laksirisamitha/MAKEEN_Keypad_Test_PCB/MAKEEN_Keypad_Test_PCB.pdf

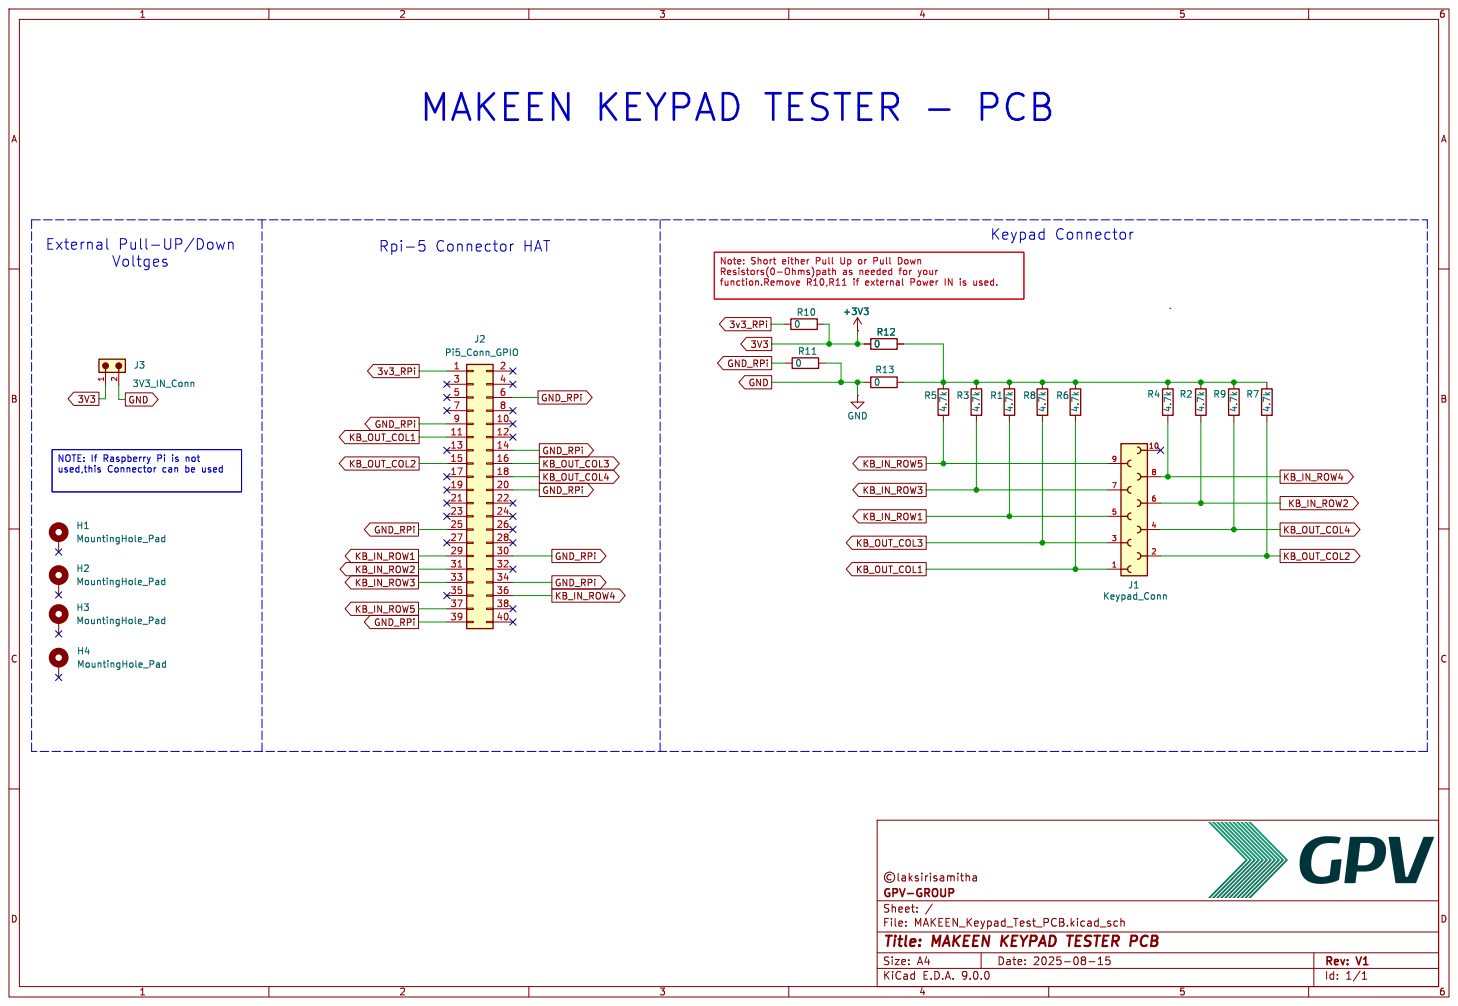
[picture p1: page 1]

External Pull-UP/Down

File: MAKEEN_Keypad_Test_PCB.kicad_sch Sheet: / GPV-GROUP

Id: 1/1 Title: MAKEEN KEYPAD TESTER PCB
