laksirisamitha/MAKEEN_Keypad_Test_PCB/MAKEEN_Keypad_Test_PCB.kicad_pcb

## KiCad design MAKEEN_Keypad_Test_PCB.kicad_pcb (2025-08-15)

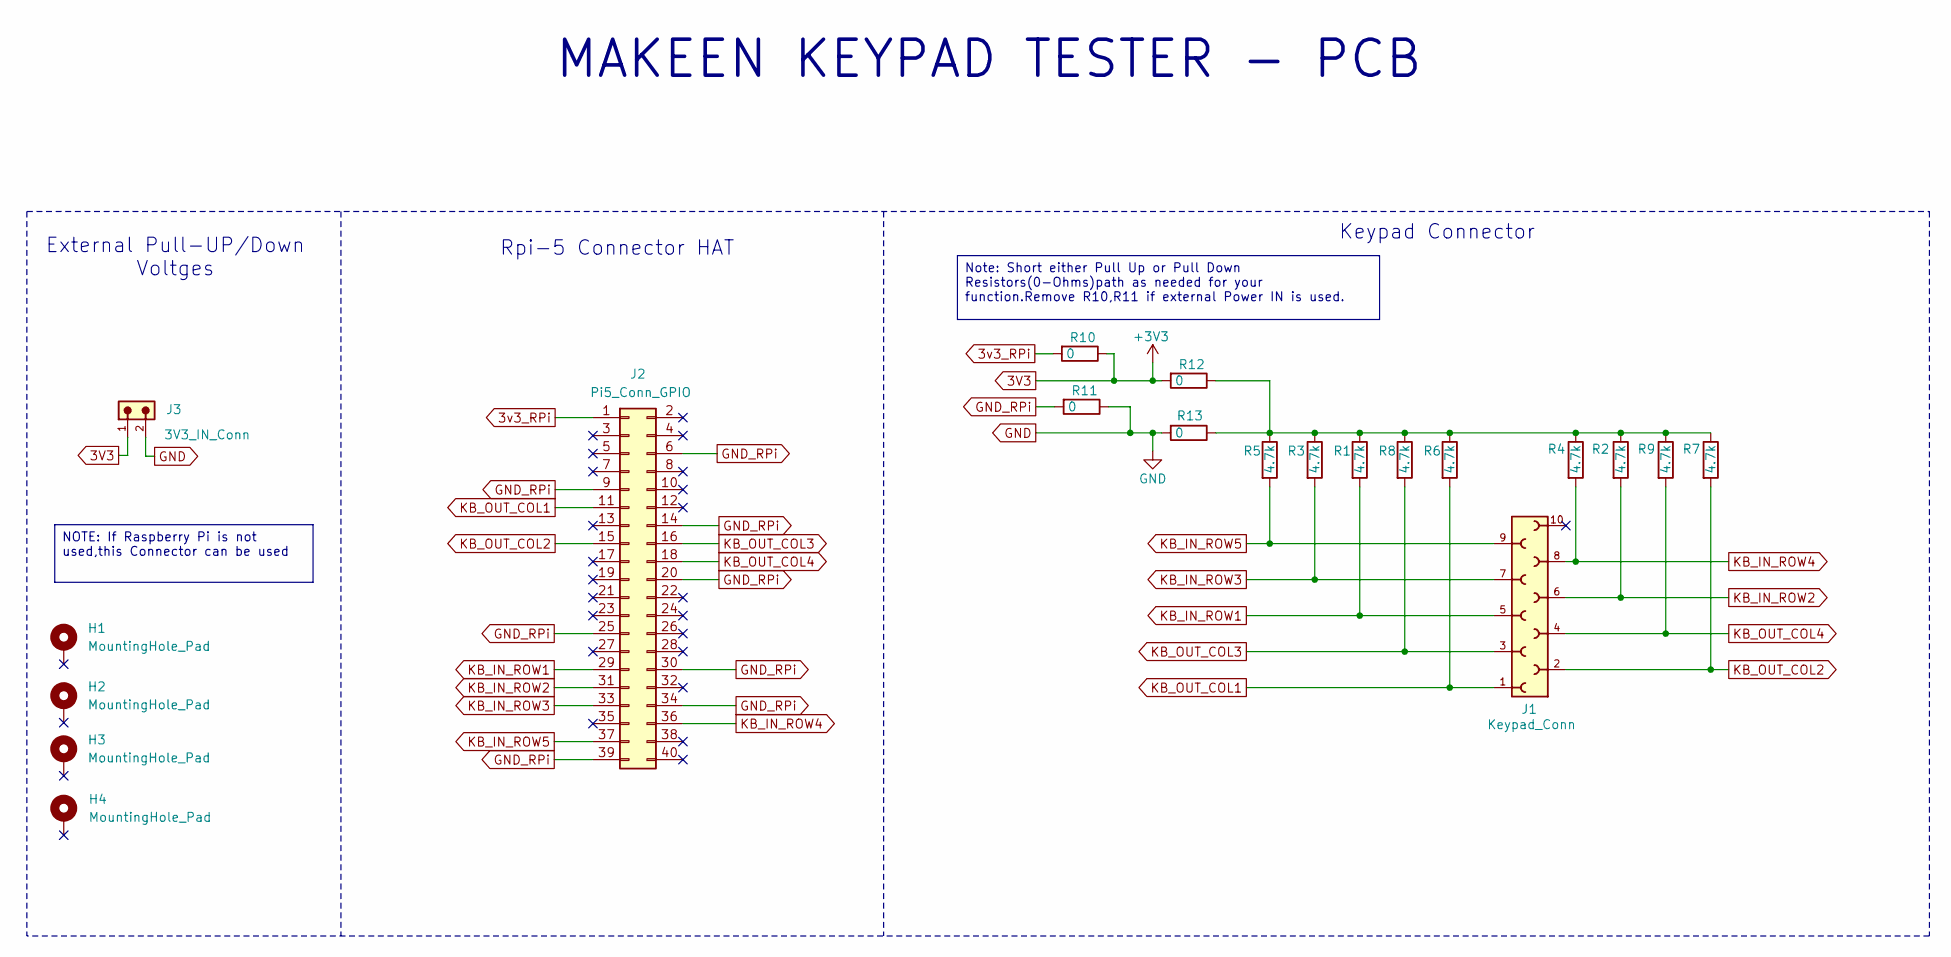
[picture p2: schematic MAKEEN_Keypad_Test_PCB.kicad_sch, MAKEEN KEYPAD TESTER PCB]

Parts:
H1, H2, H3, H4: MountingHole_Pad; MountingHole_2.7mm_M2.5_Pad
J1: Keypad_Conn; CONN_RCPT_10POS_0.1_SMD_690367281076
J2: Pi5_Conn_GPIO; PinSocket_2x20_P2.54mm_Vertical
J3: 3V3_IN_Conn; TERMBLOCK_2POS_5.08MM_691311500002
R1, R2, R3, R4, R5, R6, R7, R8, R9: 4.7k; R_0805_2012Metric_Pad1.20x1.40mm_HandSolder
R10, R11, R12, R13: 0; R_0805_2012Metric_Pad1.20x1.40mm_HandSolder

Connections:
3V3: J3.1, R10.1, R12.2
3v3_RPi: J2.1, R10.2
KB_IN_ROW2: J1.6, J2.31, R2.2
GND: J3.2, R11.1, R13.2
GND_RPi: J2.6, J2.9, J2.14, J2.20, J2.25, J2.30, J2.34, J2.39, R11.2
KB_IN_ROW1: J1.5, J2.29, R1.2
KB_IN_ROW3: J1.7, J2.33, R3.2
KB_IN_ROW4: J1.8, J2.36, R4.2
KB_IN_ROW5: J1.9, J2.37, R5.2
KB_OUT_COL1: J1.1, J2.11, R6.2
KB_OUT_COL2: J1.2, J2.15, R7.2
KB_OUT_COL3: J1.3, J2.16, R8.2
KB_OUT_COL4: J1.4, J2.18, R9.2
unnamed: R1.1, R2.1, R3.1, R4.1, R5.1, R6.1, R7.1, R8.1, R9.1, R12.1, R13.1

Notes on the sheet:
Keypad Connector
External Pull-UP/Down Voltges
MAKEEN KEYPAD TESTER - PCB
Rpi-5 Connector HAT
Note: Short either Pull Up or Pull Down Resistors(0-Ohms)path as needed for your function.Remove R10,R11 if external Power IN is used.
NOTE: If Raspberry Pi is not used,this Connector can be used

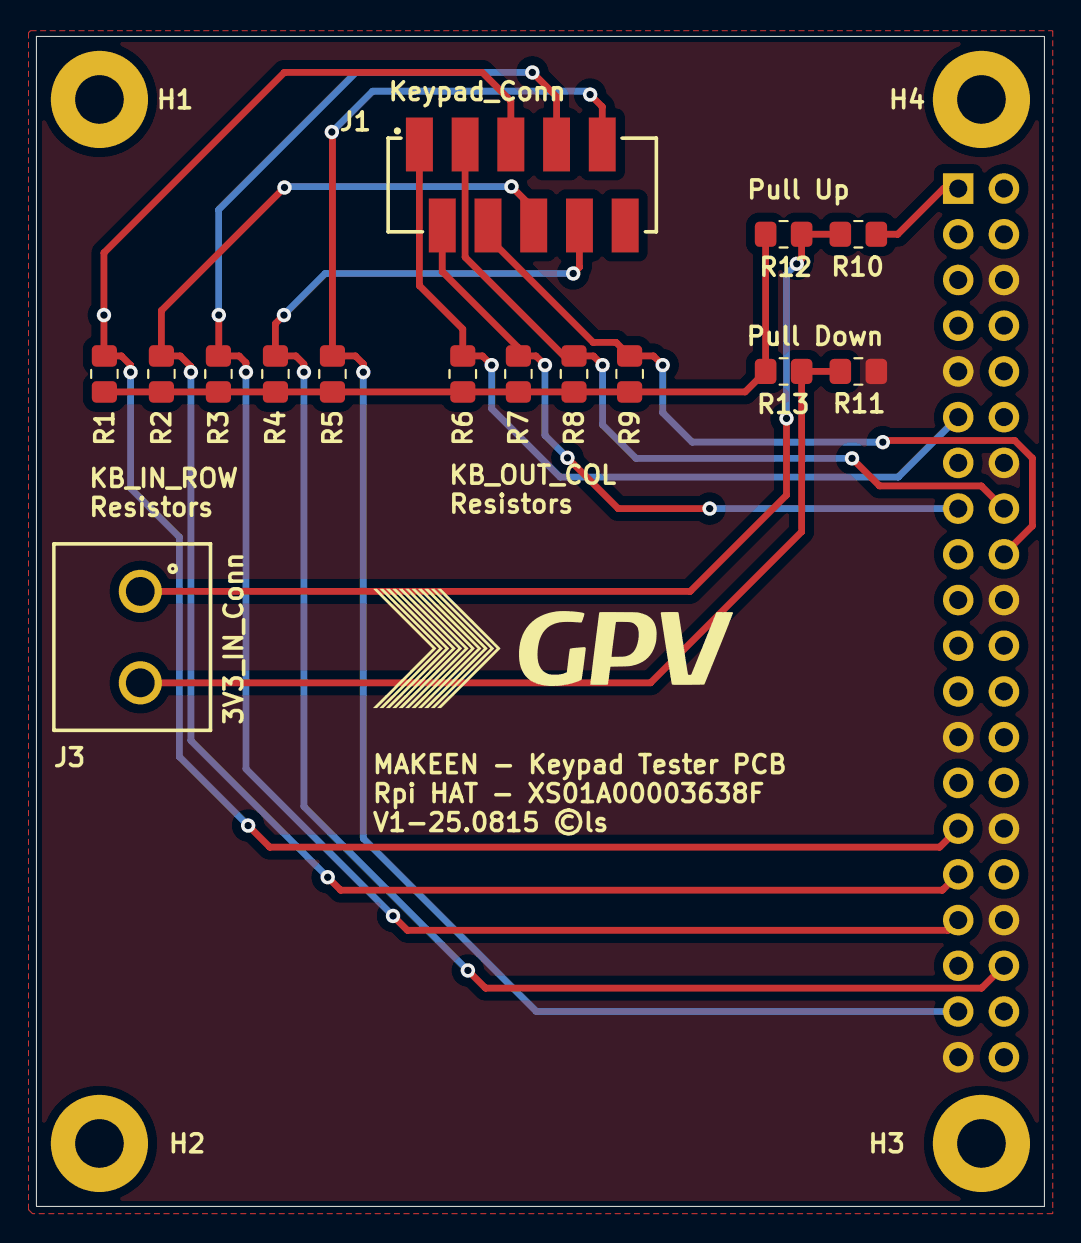
[picture p3: board MAKEEN_Keypad_Test_PCB.kicad_pcb from above]

Board: 2 copper layers, 56.0 x 65.0 mm, 20 parts (1 on the bottom side), 14 nets.
