laksirisamitha/MAKEEN_Keypad_Test_PCB/(notices)

Notices in the files:
MAKEEN_Keypad_Test_PCB.kicad_sch:
©laksirisamitha
MAKEEN_Keypad_Test_PCB.kicad_pcb:
V1-25.0815 ©ls
